shin-waseda/yuho-kicad_file/yuho.xlsx

Reference | Qty | Value | DNP | Exclude from BOM | Exclude from Board | Footprint | Datasheet
D1,D2,D3,D4 | 4 | SFH4550 | Digikey | SFH 4550 | https://www.digikey.jp/ja/products/detail/ams-osram-usa-inc/SFH-4550/806365 | LED_THT:LED_D5.0mm_IRGrey | http://www.osram-os.com/Graphics/XPic3/00116140_0.pdf
J3 | 1 | 47219-2001 | Digikey | 472192001 | https://www.digikey.jp/ja/products/detail/molex/0472192001/3044807 | Connector_Card:microSD_HC_Molex_47219-2001 | https://www.we-online.com/components/products/datasheet/693072010801.pdf
Q9 | 1 | AO3407A | Digikey | AO3407A | https://www.digikey.jp/ja/products/detail/umw/AO3407A/17635319 | Package_TO_SOT_SMD:SOT-23 | https://www.infineon.com/dgdl/irlml6402pbf.pdf?fileId=5546d462533600a401535668d5c2263c
Q12 | 1 | AO3400A | Digikey | AO3400A | https://www.digikey.jp/ja/products/detail/alpha-omega-semiconductor-inc/AO3400A/1855772 | Package_TO_SOT_SMD:SOT-23 | http://www.aosmd.com/pdfs/datasheet/AO3400A.pdf
U4 | 1 | ICM-42605 | Digikey | ICM-42605 | https://www.digikey.jp/ja/products/detail/tdk-invensense/ICM-42605/9816540 | Package_LGA:LGA-14_3x2.5mm_P0.5mm_LayoutBorder3x4y
C3 | 1 | 0.33μ | Mouser | C0805J334K5RACTU | https://www.mouser.jp/ProductDetail/KEMET/C0805J334K5RACTU?qs=6avfeC6zeS7vwSHZczzIjQ%3D%3D | Capacitor_SMD:C_0805_2012Metric_Pad1.18x1.45mm_HandSolder | https://www.mouser.jp/datasheet/3/72/1/C0805J334K5RACTU.pdf
C7 | 1 | 10n | Mouser | C0603S103K4RACAUTO | https://www.mouser.jp/ProductDetail/KEMET/C0603S103K4RACAUTO?qs=u16ybLDytRayk3DD8oxaMg%3D%3D | Capacitor_SMD:C_0603_1608Metric_Pad1.08x0.95mm_HandSolder
D6,D13 | 2 | MBR130LSFT1G | Mouser | MBR130LSFT1G | https://www.mouser.jp/ProductDetail/onsemi/MBR130LSFT1G?qs=3JMERSakeboa9OM6bbJQ3g%3D%3D | Diode_SMD:D_SOD-123F
R3,R5,R8,R11 | 4 | 20 | Mouser | ERJ-PA3F20R0V | https://www.mouser.jp/ProductDetail/Panasonic/ERJ-PA3F20R0V?qs=BzJM0faLVqXFujrHQ6zX5g%3D%3D&mgh=1&vip=1 | Resistor_SMD:R_0603_1608Metric_Pad0.98x0.96mm_HandSolder | https://www.mouser.jp/ProductDetail/Panasonic/ERJ-PA3F20R0V?qs=BzJM0faLVqXFujrHQ6zX5g%3D%3D&mgh=1&vip=1
U2 | 1 | LD1117S25TR_SOT223 | Mouser | LD1117S25TR | https://www.mouser.jp/ProductDetail/STMicroelectronics/LD1117S25TR?qs=uWoDHEC%252Bq2%2FKaE8ZseXscw%3D%3D | Package_TO_SOT_SMD:SOT-223-3_TabPin2 | http://www.st.com/st-web-ui/static/active/en/resource/technical/document/datasheet/CD00000544.pdf
U6,U7 | 2 | 74HC595D | Mouser | 74HC595D | https://www.mouser.jp/ProductDetail/Toshiba/74HC595D?qs=7EBvPakHacViJoQmXKcnew%3D%3D | Fusoku:SOIC127P600X175-16N | http://www.ti.com/lit/ds/symlink/sn74hc595.pdf
LS1 | 1 | SMT-0540-S-R | Mouser | SMT-0540-S-R | https://www.mouser.jp/ProductDetail/PUI-Audio/SMT-0540-S-R?qs=e16JbV5WBEu5VaDVzQP23Q%3D%3D | Fusoku:XDCR_SMT-0540-S-R
Q2,Q4,Q6,Q8 | 4 | ST-1KL3A | アールティロボショップ | コーデンシ製フォトトランジスタST-1KL3A 10個入り | https://www.rt-shop.jp/index.php?main_page=product_info&products_id=2747 | LED_THT:LED_D3.0mm_Horizontal_O1.27mm_Z2.0mm_Clear
BAT1 | 1 | Conn_01x02 | 秋月 | [108978]2mmピッチピンヘッダー 1×10 (10P) | https://akizukidenshi.com/catalog/g/g108978/ | Connector_PinSocket_2.00mm:PinSocket_2x01_P2.00mm_Vertical
C1 | 1 | 22μ | 秋月 | [106045]チップ積層セラミックコンデンサー 22μF16V B 3225 | https://akizukidenshi.com/catalog/g/g106045/ | Capacitor_SMD:C_1210_3225Metric_Pad1.33x2.70mm_HandSolder | https://akizukidenshi.com/goodsaffix/GRM32EB31C226KE16.pdf
C2 | 1 | 1.0μ | 秋月 | [114526]チップ積層セラミックコンデンサー 1μF25V X7R 1608 | https://akizukidenshi.com/catalog/g/g114526/ | Capacitor_SMD:C_0603_1608Metric_Pad1.08x0.95mm_HandSolder | https://akizukidenshi.com/goodsaffix/GRM188R71E105KA12.pdf
C4 | 1 | 4.7μ | 秋月 | [107548]チップ積層セラミックコンデンサー 4.7μF50V X5R 2012 | https://akizukidenshi.com/catalog/g/g107548/ | Capacitor_SMD:C_0805_2012Metric_Pad1.18x1.45mm_HandSolder | https://akizukidenshi.com/goodsaffix/CL21A475KBQNNNE.pdf
C5,C9,C11,C12,C16,C17,C18,C20,C21,C22,C23,C24,C27 | 13 | 0.1μ | 秋月 | [116143]チップ積層セラミックコンデンサー 0.1μF50V X8L 1608 | https://akizukidenshi.com/catalog/g/g116143/ | Capacitor_SMD:C_0603_1608Metric_Pad1.08x0.95mm_HandSolder
C6,C13,C14 | 3 | 2.2μ | 秋月 | [116077]チップ積層セラミックコンデンサー 2.2μF35V B 1608 | https://akizukidenshi.com/catalog/g/g116077/ | Capacitor_SMD:C_0603_1608Metric_Pad1.08x0.95mm_HandSolder
C8,C10,C15 | 3 | 10μ | 秋月 | [113161]チップ積層セラミックコンデンサー 10μF35V X5R 1608 | https://akizukidenshi.com/catalog/g/g113161/ | Capacitor_SMD:C_0603_1608Metric_Pad1.08x0.95mm_HandSolder
C19 | 1 | 1μ | 秋月 | [114526]チップ積層セラミックコンデンサー 1μF25V X7R 1608 | https://akizukidenshi.com/catalog/g/g114526/ | Capacitor_SMD:C_0603_1608Metric_Pad1.08x0.95mm_HandSolder
C25 | 1 | 4.7μ | 秋月 | [109218]チップ積層セラミックコンデンサー 4.7μF10V F 1608 | https://akizukidenshi.com/catalog/g/g109218/ | Capacitor_SMD:C_0603_1608Metric_Pad1.08x0.95mm_HandSolder
C26 | 1 | 100μ | 秋月 | [113710]チップ積層セラミックコンデンサー 100μF10V X5R 3216 | https://akizukidenshi.com/catalog/g/g113710/ | Capacitor_SMD:C_1206_3216Metric_Pad1.33x1.80mm_HandSolder
J1 | 1 | Conn_02x05_Odd_Even | 秋月 | [110904]ピンヘッダー 2×5(10P) 表面実装用 1.27mmピッチ | https://akizukidenshi.com/catalog/g/g110904/ | Connector_PinSocket_1.27mm:PinSocket_2x05_P1.27mm_Vertical_SMD
J2,J4 | 2 | Conn_02x04_Odd_Even | 秋月 | [113800]ピンヘッダー 1.27mm 2×5(10P) | https://akizukidenshi.com/catalog/g/g113800/ | Connector_PinHeader_1.27mm:PinHeader_2x04_P1.27mm_Vertical
Q1,Q3,Q5,Q7,Q10 | 5 | 2N7002K | 秋月 | [104256]NchMOSFET 60V300mA 2N7002K | https://akizukidenshi.com/catalog/g/g104256/ | Package_TO_SOT_SMD:SOT-23 | https://www.diodes.com/assets/Datasheets/ds30896.pdf
R2,R4,R7,R10,R16,R17,R18,R19,R27,R28,R30,R37,R38,R39,R40,R42 | 16 | 10k | 秋月 | [130355]チップ抵抗 1608 1/10W10kΩ | https://akizukidenshi.com/catalog/g/g130355/ | Resistor_SMD:R_0603_1608Metric_Pad0.98x0.95mm_HandSolder
R13 | 1 | 0 | 秋月 | [111619]角形ジャンパーチップ抵抗器 1608 0Ω | https://akizukidenshi.com/catalog/g/g111619/ | Resistor_SMD:R_0603_1608Metric_Pad0.98x0.95mm_HandSolder
SW1 | 1 | 113989 | 秋月 | [113989]表面実装用スライドスイッチ 1回路2接点 横向き | https://akizukidenshi.com/catalog/g/g113989/ | Button_Switch_SMD:Nidec_Copal_CAS-120A | https://www.nidec-components.com/e/catalog/switch/cas.pdf
SW2,SW3,SW4 | 3 | SKRPACE010 | 秋月 | [106185]表面実装用タクトスイッチ 2.55N SKRPACE010 | https://akizukidenshi.com/catalog/g/g106185/ | Fusoku:SW_SKRPACE010_AAL
U1 | 1 | STM32F405RGTx | 秋月 | [113219]STM32マイコン STM32F405RGT6 | https://akizukidenshi.com/catalog/g/g113219/ | Package_QFP:LQFP-64_10x10mm_P0.5mm | https://www.st.com/resource/en/datasheet/stm32f405rg.pdf
U3 | 1 | NJM2884U1 | 秋月 | [110673]低飽和型レギュレーター 3.3V500mA NJM2884U1-33 | https://akizukidenshi.com/catalog/g/g110673/ | Package_TO_SOT_SMD:SOT-89-5
U5 | 1 | TB6612FNG | 秋月 | [111317]デュアルDCモータードライバーIC TB6612FNG | https://akizukidenshi.com/catalog/g/g111317/ | Package_SO:SSOP-24_5.3x8.2mm_P0.65mm | https://toshiba.semicon-storage.com/us/product/linear/motordriver/detail.TB6612FNG.html
J_L1,J_R1 | 2 | Conn_02x03_Odd_Even | 秋月に | [100083]ピンソケット (メス) 2×10 (20P) | https://akizukidenshi.com/catalog/g/g100083/ | Connector_PinSocket_2.54mm:PinSocket_2x03_P2.54mm_Vertical
R14 | 1 | 33k | 千石 | KOA RK73B1JTTD333J | https://www.sengoku.co.jp/mod/sgk_cart/detail.php?code=EEHD-57H4 | Resistor_SMD:R_0603_1608Metric_Pad0.98x0.95mm_HandSolder
R41 | 1 | 33 | 千石 | KOA RK73B1JTTD330J | https://www.sengoku.co.jp/mod/sgk_cart/detail.php?code=EEHD-57FH | Resistor_SMD:R_0603_1608Metric_Pad0.98x0.95mm_HandSolder
R1,R6,R9,R12,R20,R21,R22,R23,R24,R25,R26,R31,R32,R33,R34,R35,R36,R43,R44,R45,R46,R47,R48,R49,R50,R51,R52 | 27 | 560 | マルツ | RG1608P-561-B | https://www.marutsu.co.jp/pc/i/2577825/ | Resistor_SMD:R_0603_1608Metric_Pad0.98x0.95mm_HandSolder
D5,D7,D8,D9,D10,D11,D12,D14,D15,D16,D17,D18,D19,D20,D21,D22,D23,D24,D25,D26,D27,D28,D29 | 23 | LED |  |  |  | LED_SMD:LED_0603_1608Metric_Pad1.05x0.95mm_HandSolder
FAN1 | 1 | 8520モータ |  |  |  | Connector_JST:JST_PH_B2B-PH-K_1x02_P2.00mm_Vertical
R15 | 1 | 20k |  |  |  | Resistor_SMD:R_0603_1608Metric_Pad0.98x0.95mm_HandSolder
