shin-waseda/yuho-kicad_file/3D/Assem1.SLDASM

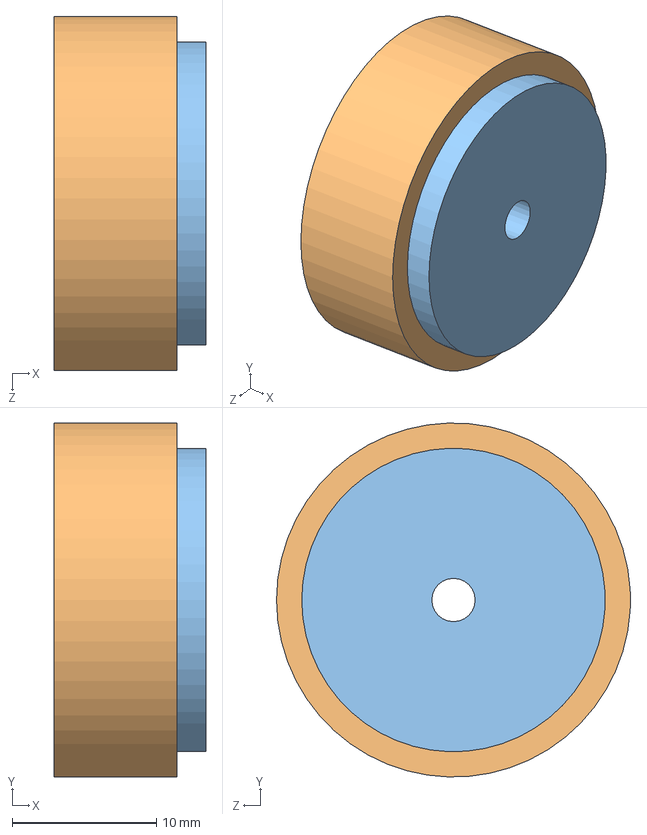
[picture p1: CAD file, 2026-05-11]
3D/Assem1.SLDASM
10.5 x 24.5 x 24.5 mm
supr_gear
tire
wheel
