shin-waseda/yuho-kicad_file/3D/Assembly1.SLDASM

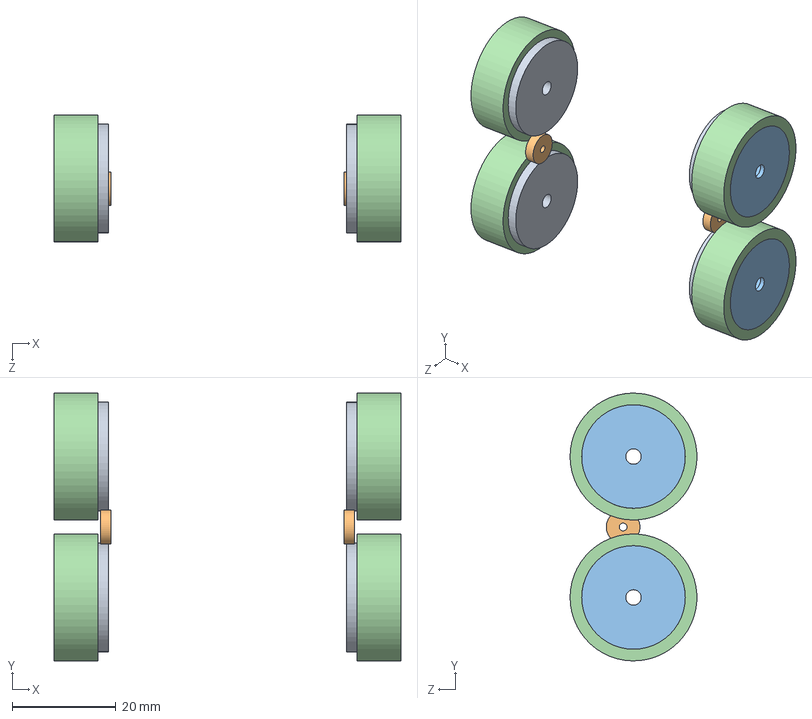
[picture p2: CAD file, 2026-04-03]
3D/Assembly1.SLDASM
67.0 x 51.7 x 24.5 mm
tire x 4
wheel x 4
pinion_gear x 2
supr_gear x 4
