shin-waseda/yuho-kicad_file/3D/sensor_mount.STEP

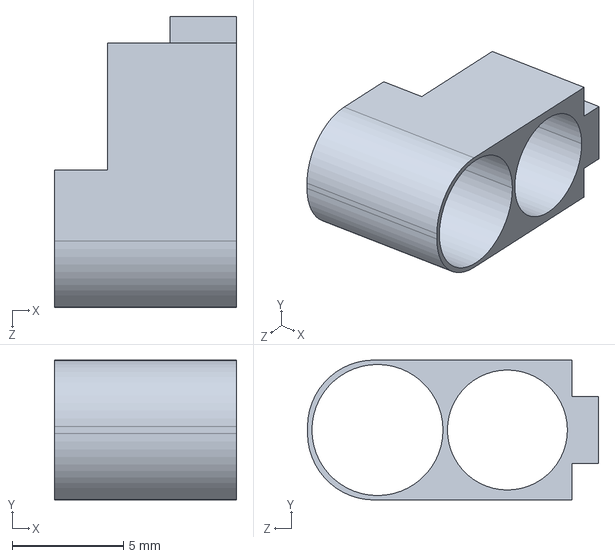
[picture p3: CAD file, 2026-05-11]
3D/sensor_mount.STEP
8.20 x 6.30 x 13.1 mm
