shin-waseda/yuho-kicad_file/3D/motor_mount_v3.STEP

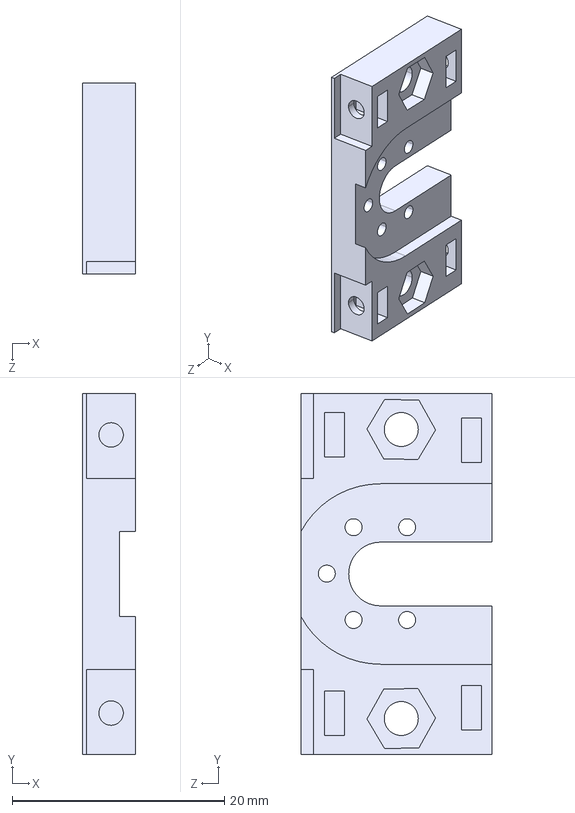
[picture p4: CAD file, 2026-05-11]
3D/motor_mount_v3.STEP
5.00 x 34.0 x 18.0 mm
