shin-waseda/yuho-kicad_file/3D/pin_vise.STEP

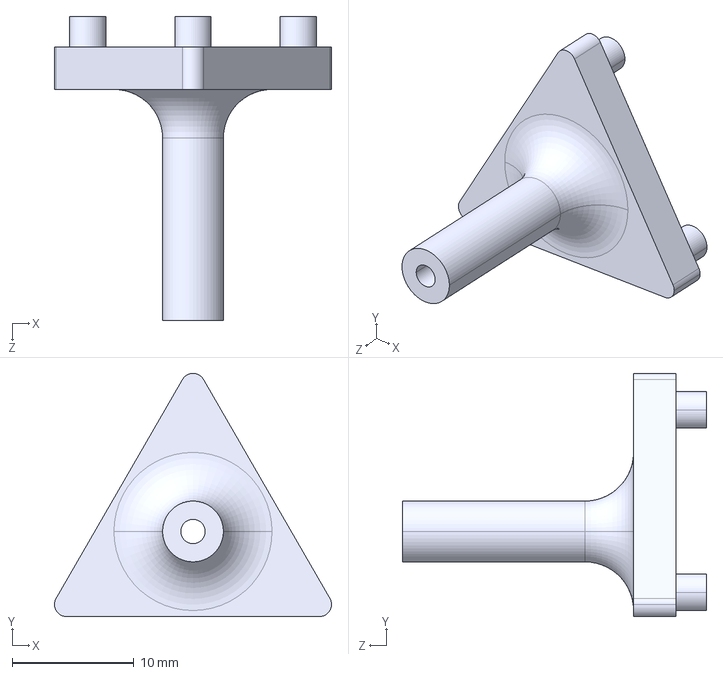
[picture p5: CAD file, 2026-05-11]
3D/pin_vise.STEP
22.8 x 20.0 x 25.0 mm
