shin-waseda/yuho-kicad_file/3D/base_plate.STEP

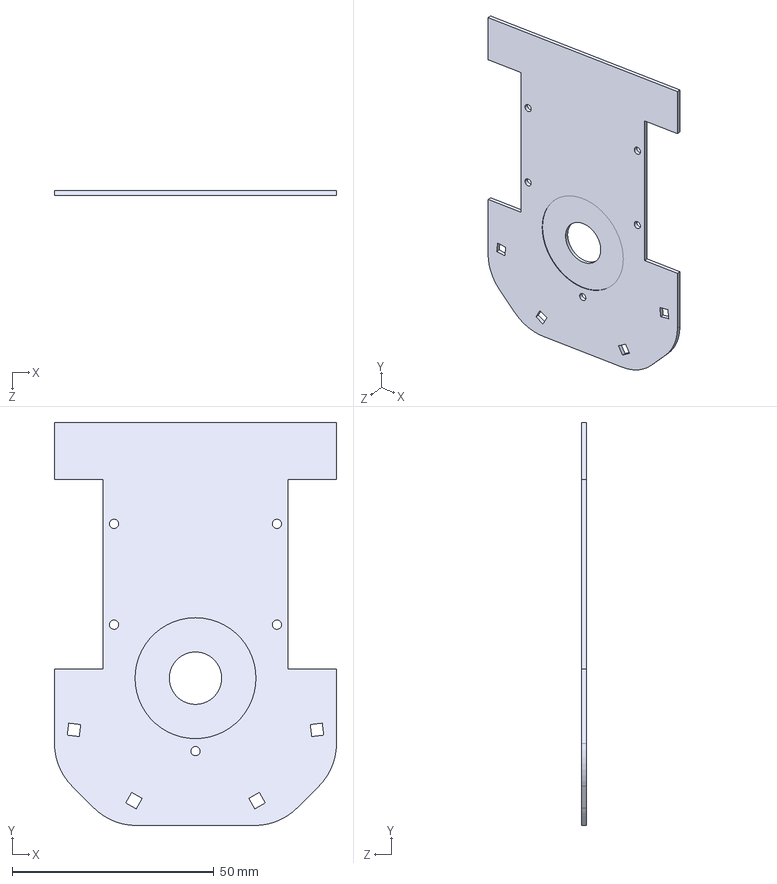
[picture p6: CAD file, 2026-05-11]
3D/base_plate.STEP
70.0 x 100.0 x 1.20 mm
