shin-waseda/yuho-kicad_file/3D/fun_mount.STEP

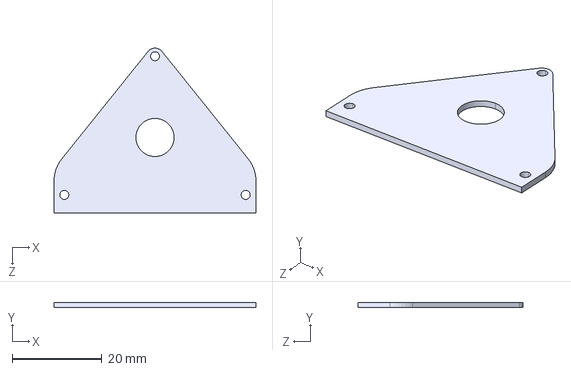
[picture p7: CAD file, 2026-05-11]
3D/fun_mount.STEP
45.0 x 1.20 x 36.7 mm
