shin-waseda/yuho-kicad_file/3D/2nd_plate.STEP

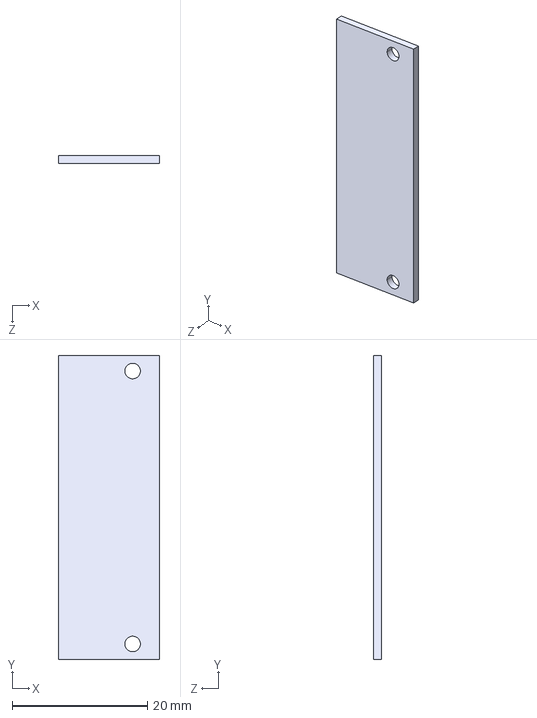
[picture p8: CAD file, 2026-05-11]
3D/2nd_plate.STEP
15.0 x 45.0 x 1.20 mm
