shin-waseda/yuho-kicad_file/3D/2nd_plate_edge.DXF

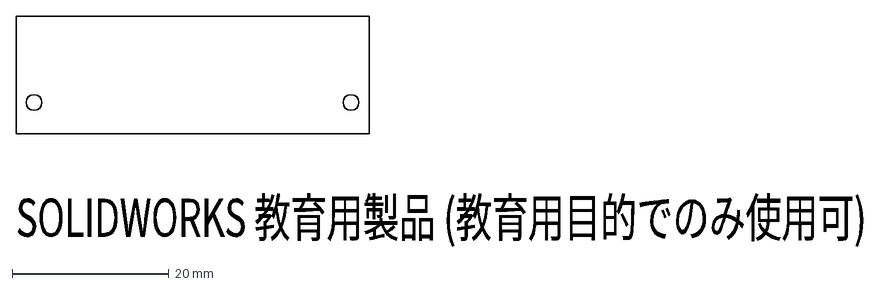
[picture p9: CAD file, 2026-04-03]
3D/2nd_plate_edge.DXF
SOLIDWORKS 教育用製品 (教育用目的でのみ使用可)
