shin-waseda/yuho-kicad_file/3D/1717_connector.SLDPRT

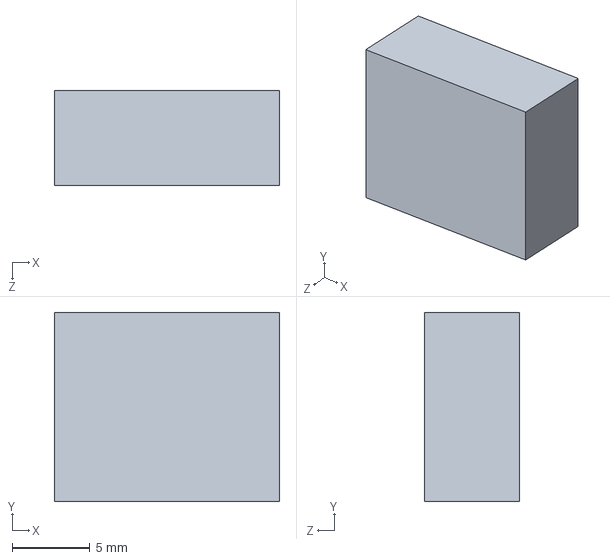
[picture p10: CAD file, 2026-04-03]
3D/1717_connector.SLDPRT
14.5 x 12.2 x 6.10 mm
