shin-waseda/yuho-kicad_file/3D/wheel.SLDPRT

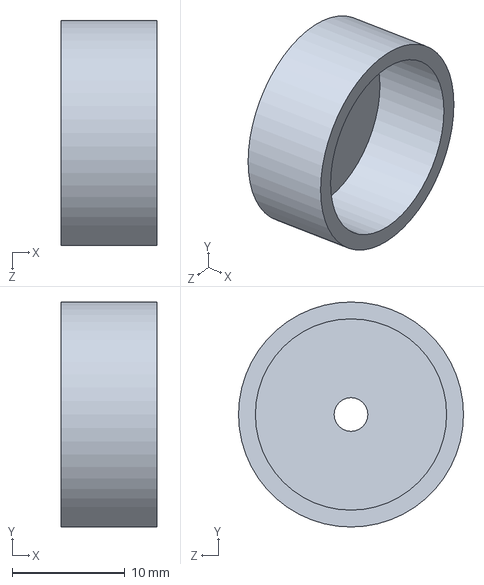
[picture p11: CAD file, 2026-04-03]
3D/wheel.SLDPRT
8.50 x 20.0 x 20.0 mm
