shin-waseda/yuho-kicad_file/3D/pinion_gear.SLDPRT

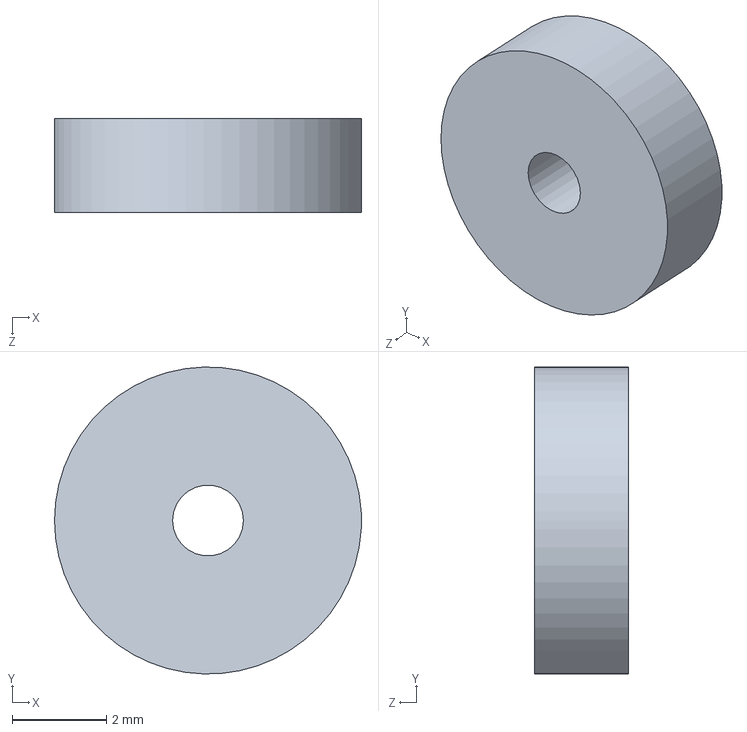
[picture p12: CAD file, 2026-04-03]
3D/pinion_gear.SLDPRT
6.50 x 6.50 x 2.00 mm
