shin-waseda/yuho-kicad_file/3D/2-5_connector.SLDPRT

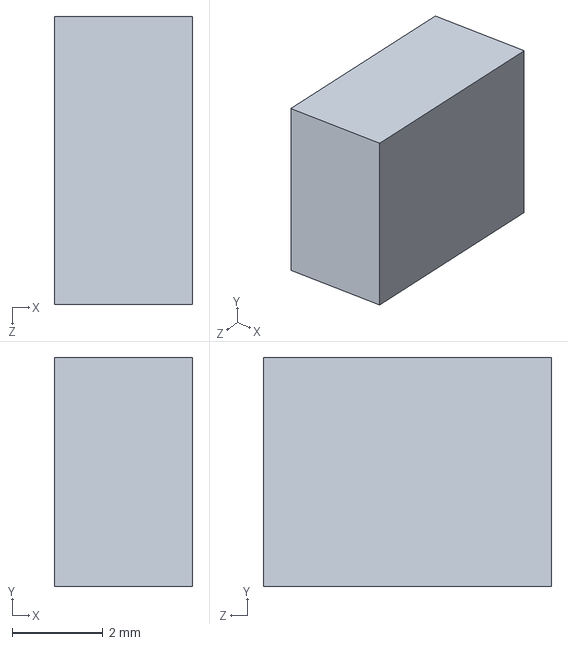
[picture p14: CAD file, 2026-04-03]
3D/2-5_connector.SLDPRT
3.05 x 5.05 x 6.35 mm
