shin-waseda/yuho-kicad_file/3D/supr_gear.SLDPRT

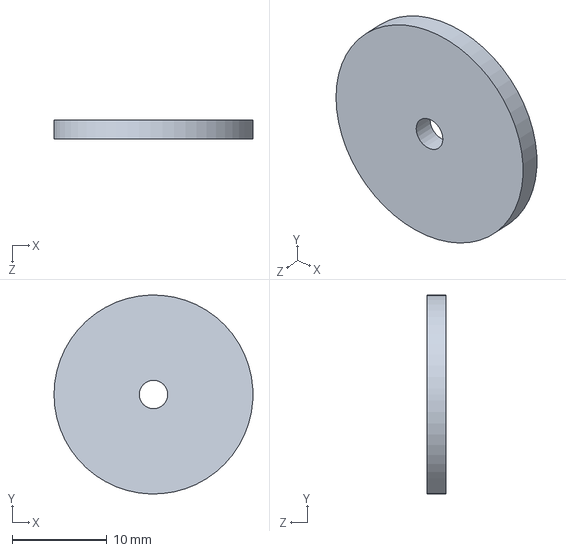
[picture p15: CAD file, 2026-04-03]
3D/supr_gear.SLDPRT
21.0 x 21.0 x 2.00 mm
