shin-waseda/yuho-kicad_file/3D/Assem2.STEP

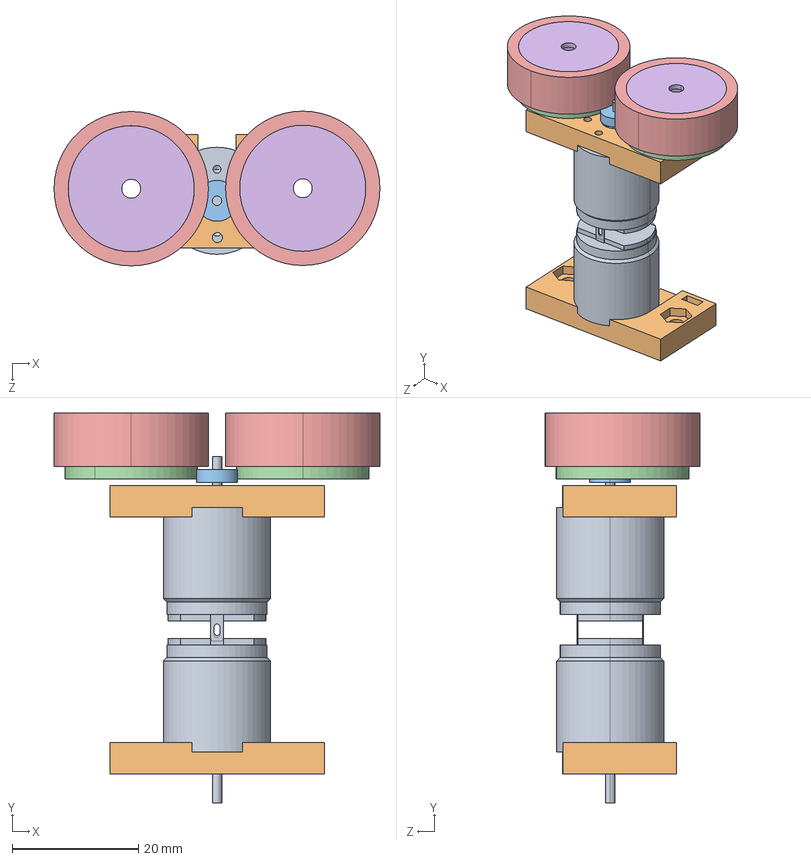
[picture p16: CAD file, 2026-04-03]
3D/Assem2.STEP
51.7 x 61.9 x 24.6 mm
1717T_SR.stp x 2
motor_mount_v2 x 2
pinion_gear
supr_gear x 2
tire x 2
wheel x 2
