shin-waseda/yuho-kicad_file/3D/tire.SLDPRT

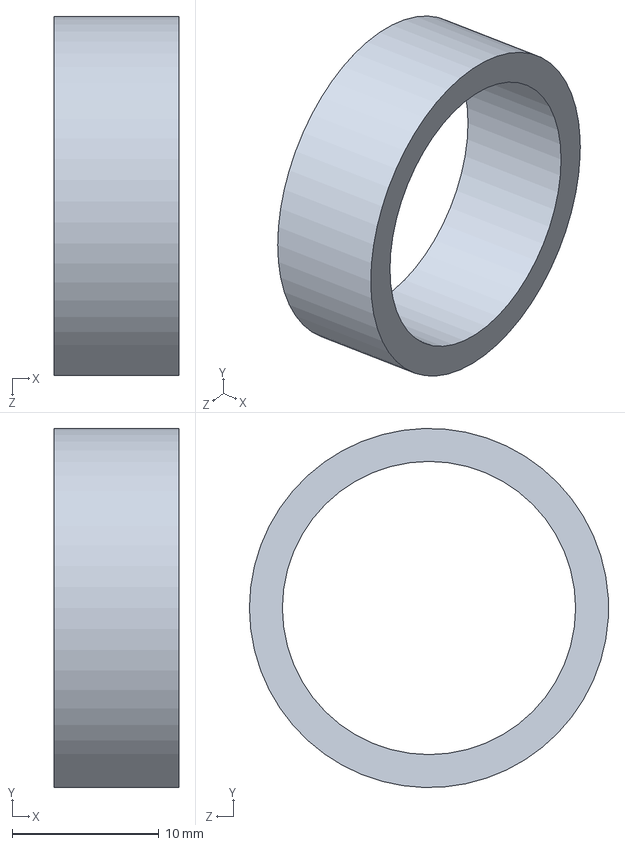
[picture p17: CAD file, 2026-04-03]
3D/tire.SLDPRT
8.50 x 24.5 x 24.5 mm
