shin-waseda/yuho-kicad_file/3D/Assem3.SLDASM

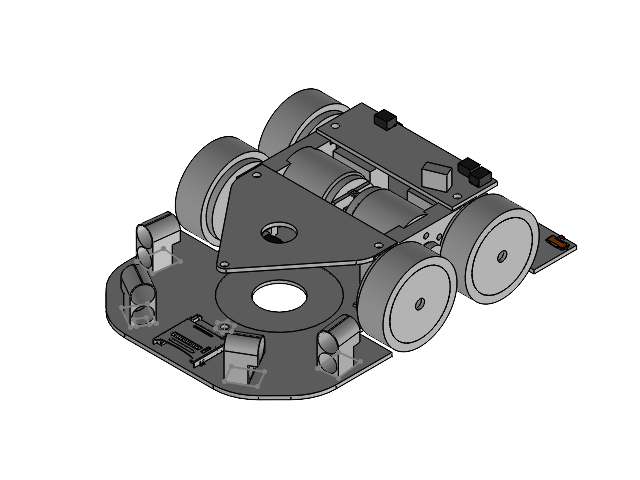
[picture p18: CAD file, 2026-05-11]
3D/Assem3.SLDASM
1717T_SR.stp x 2
pinion_gear x 2
supr_gear x 4
tire x 4
wheel x 4
base_plate
472192001.stp
SMT-0540-S-R.step
motor_mount_v3 x 2
SW_SKRPACE010_AAL.step x 3
SSAJ120100.step
Parte DW.stp
Parte UP.stp
Lead.stp x 64
DiePad.stp
74HC595D.stp x 2
2nd_plate
SSM3K344R.stp
PinSocket_1x02_P2.54mm_Vertical.step
PinSocket_1x02_P2.00mm_Vertical.step
sensor_mount x 4
1717_connector x 2
2-5_connector
fun_mount
