shin-waseda/yuho-kicad_file/(list of files, cad)

Other CAD files:
3D/2nd_plate.DXF
3D/2nd_plate.SLDPRT
3D/Assem2.SLDASM
3D/Assem3.DXF
3D/base_plate.DXF
3D/base_plate.SLDPRT
3D/fun_mount.SLDPRT
3D/motor_mount.SLDPRT
3D/motor_mount_v2.SLDPRT
3D/motor_mount_v3.SLDPRT
3D/pin_vise.SLDPRT
3D/sensor_mount.SLDPRT
