shin-waseda/yuho-kicad_file/(commit log)

2026-04-03 Initial commit before KiCad 10 update
    [1717_connector.SLDPRT, 2-5_connector.SLDPRT, 2nd_plate.DXF, 2nd_plate.SLDPRT, 2nd_plate.STEP, 2nd_plate_edge.DXF, Assem2.SLDASM, Assem2.STEP]
2026-05-11 発注用のもの(だと信じたい)ver
    [2nd_plate.SLDPRT, 2nd_plate.STEP, Assem1.SLDASM, Assem3.SLDASM, base_plate.SLDPRT, base_plate.STEP, fun_mount.SLDPRT, fun_mount.STEP]
